OneVariable/ov-twin/README.md

# OneVariable Twin Trainer Hardware

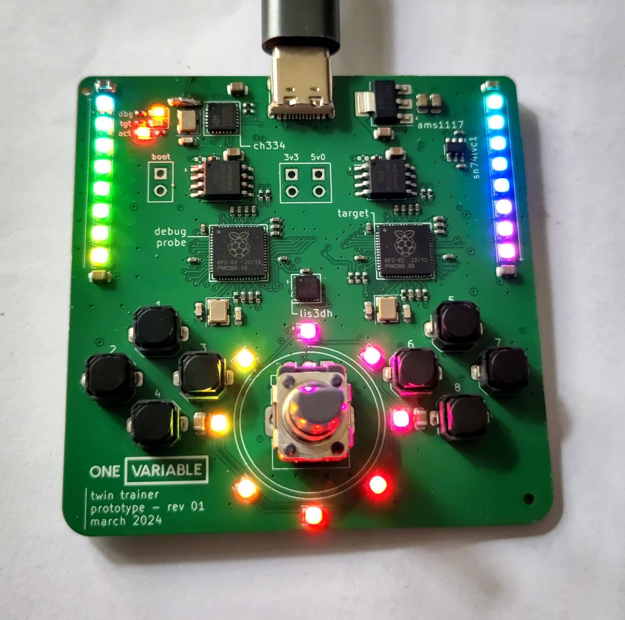
[picture p1: assets/ovtwin-001.jpg]
OV Twin Revision 1


Hardware for the OV Twin Trainer Board.

Designed for [RustNL 2024 Workshops](https://2024.rustnl.org/workshops/)

## Schematic

You can view the PDF schematic [here](./assets/ov-twin.pdf).
