OneVariable/ov-twin/ov-twin.kicad_pcb

## KiCad design ov-twin.kicad_pcb (2024-04-11)

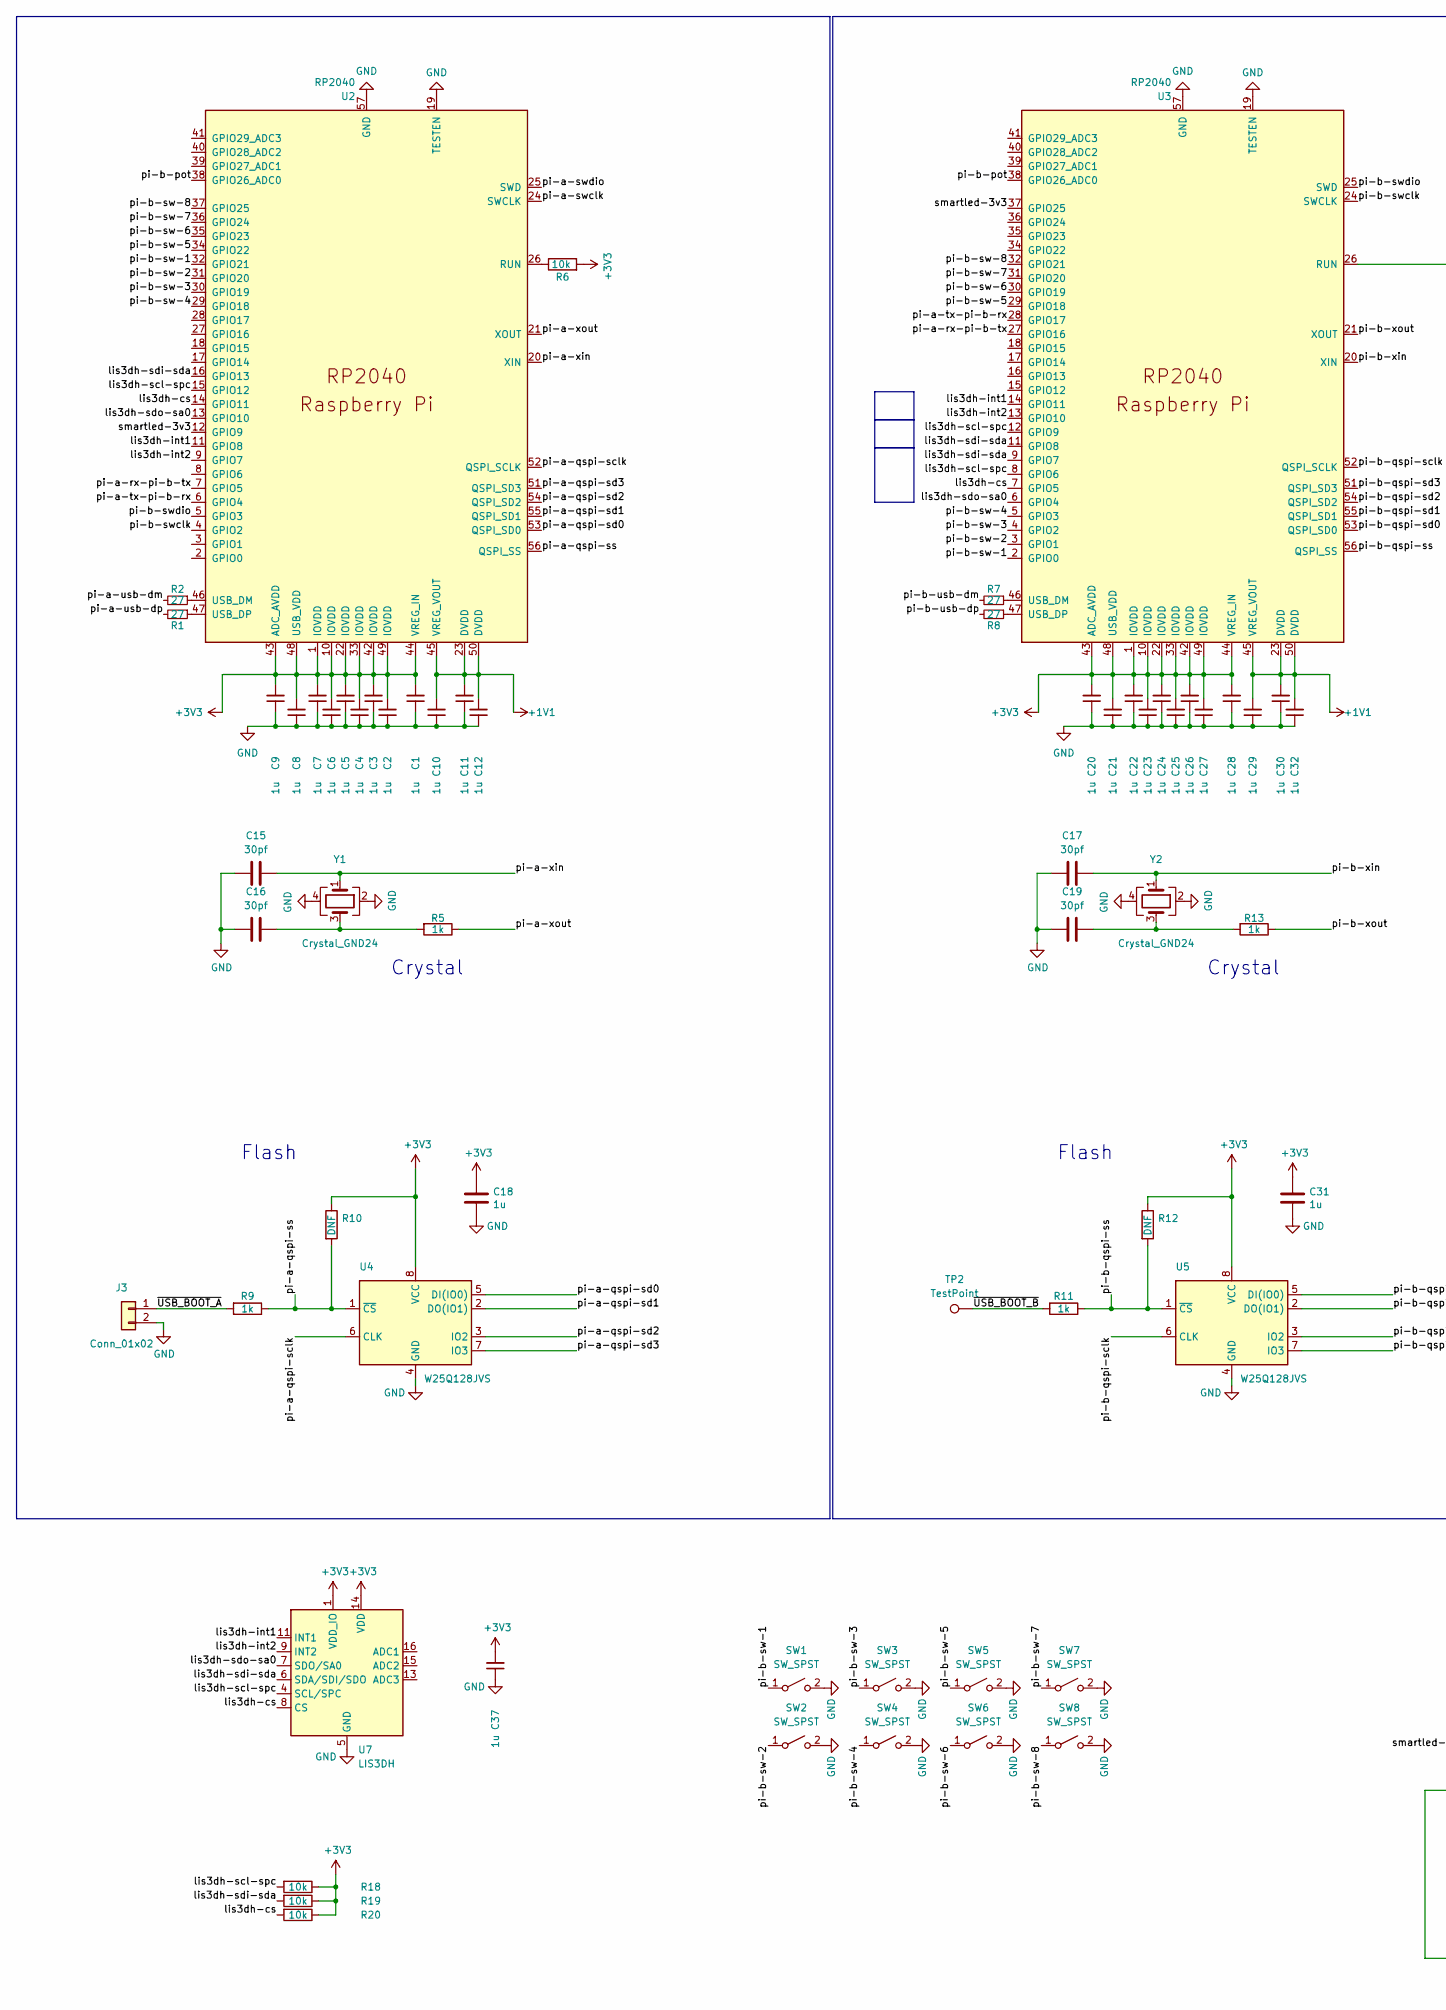
[picture p3: schematic ov-twin.kicad_sch, part in row 1, column 1]

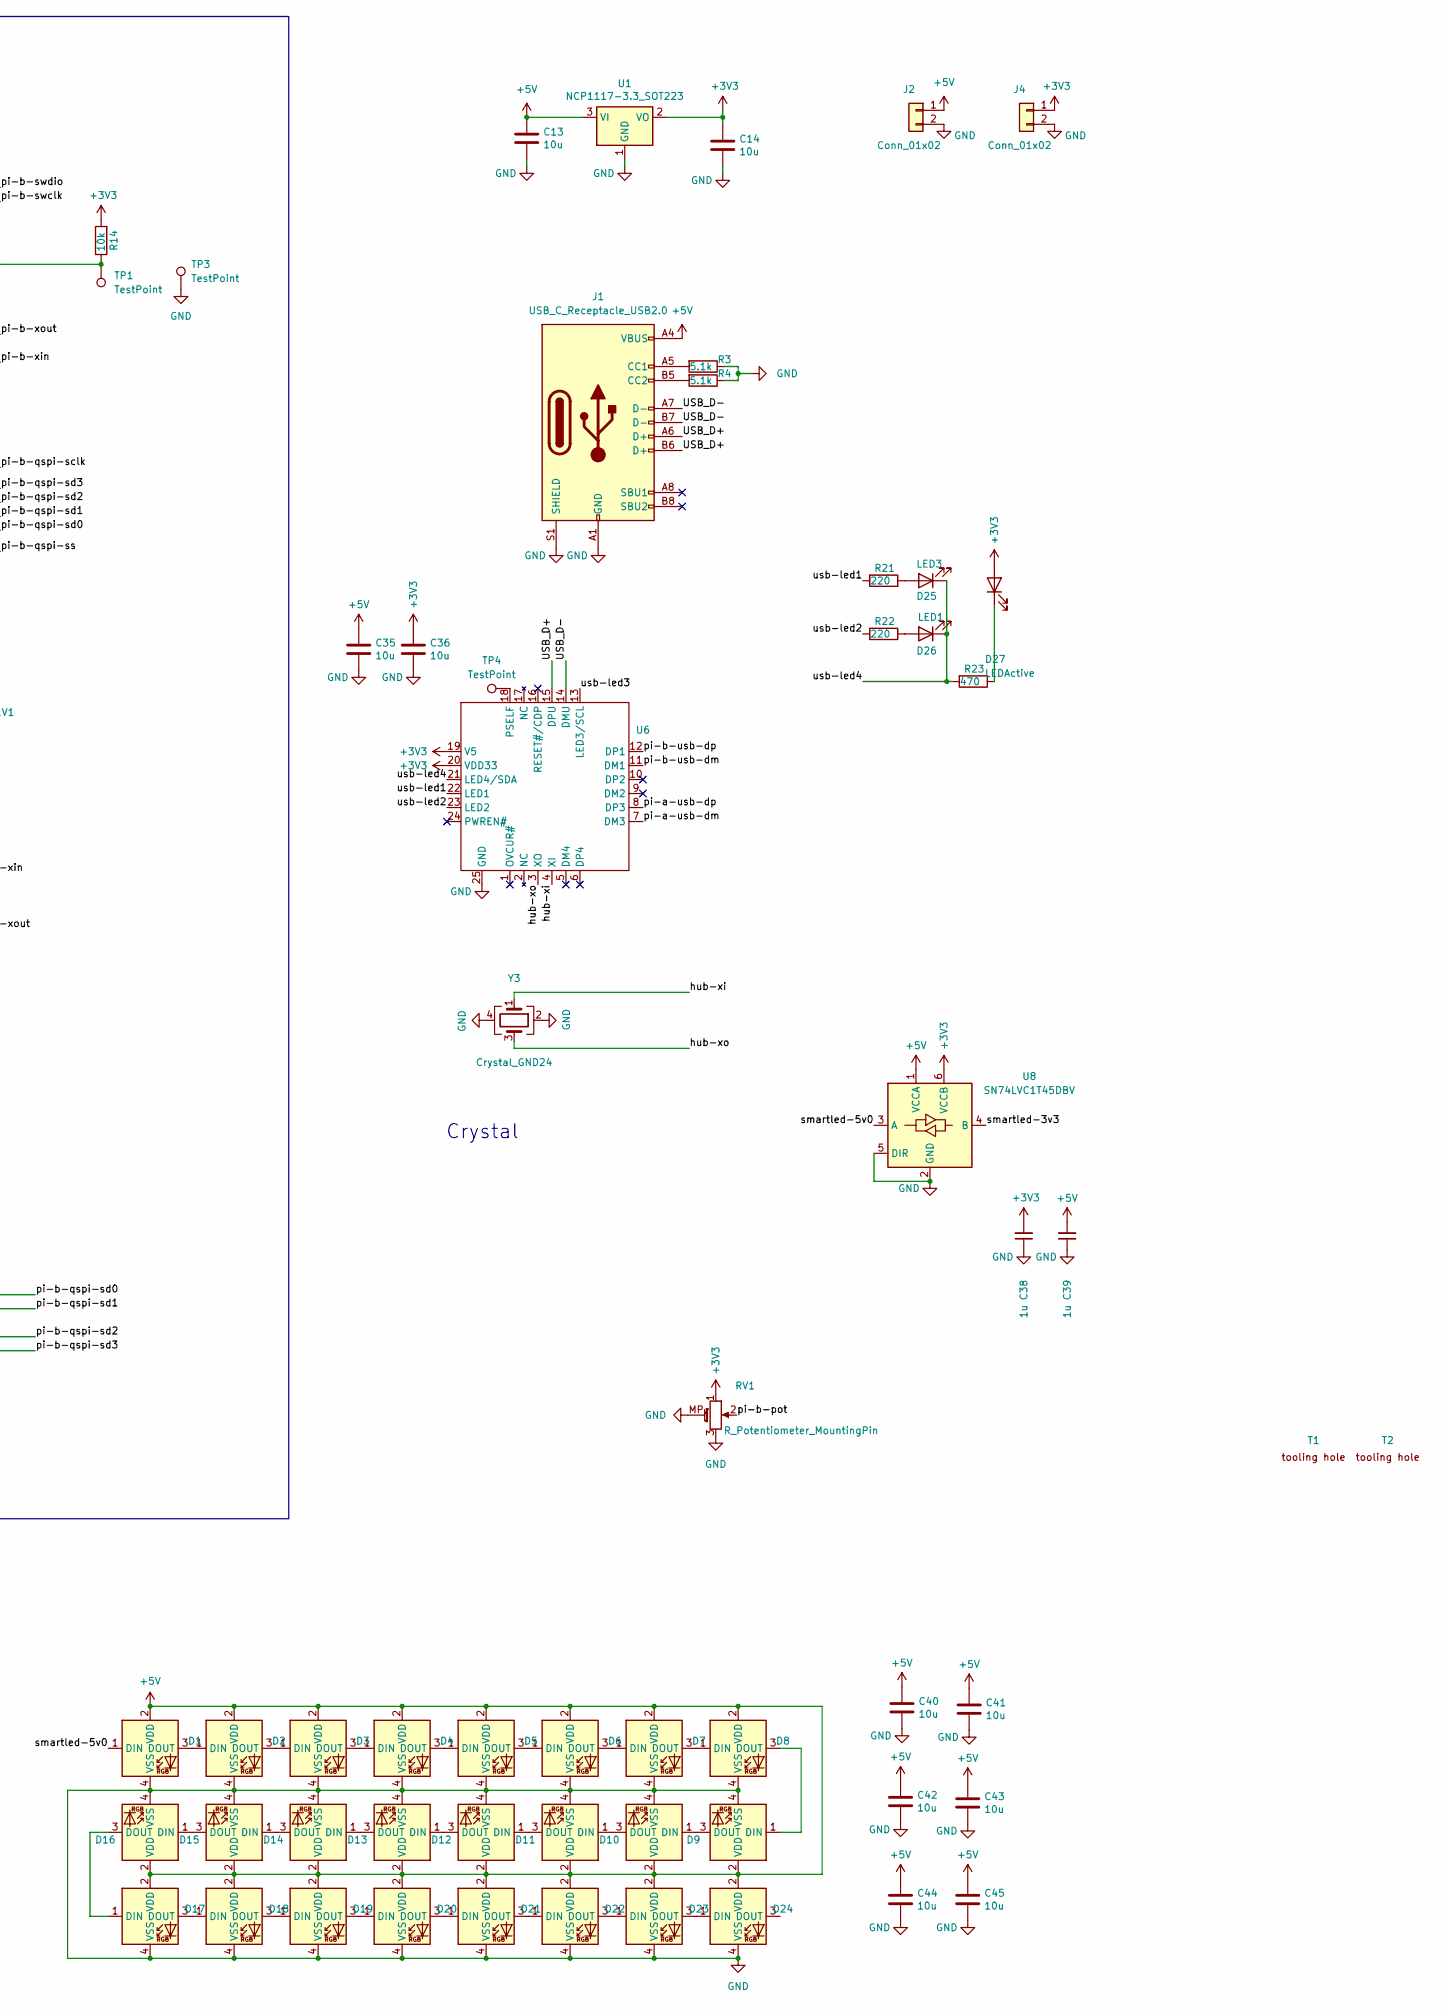
[picture p4: schematic ov-twin.kicad_sch, part in row 1, column 2]

Parts:
C1, C2, C3, C4, C5, C6, C7, C8, C9, C10, C11, C12, C20, C21, C22, C23, C24, C25, C26, C27, C28, C29, C30, C32, C37, C38, C39: 1u; C_0402_1005Metric
C13, C14, C35, C36, C40, C41, C42, C43, C44, C45: 10u; C_0805_2012Metric
C15, C16, C17, C19: 30pf; C_0603_1608Metric
C18, C31: 1u; C_0805_2012Metric
D1, D2, D3, D4, D5, D6, D7, D8, D9, D10, D11, D12, D13, D14, D15, D16, D17, D18, D19, D20, D21, D22, D23, D24: LED_WS2812B-2020_PLCC4_2.0x2.0mm
D25: LED3; LED_0603_1608Metric
D26: LED1; LED_0603_1608Metric
D27: LEDActive; LED_0603_1608Metric
J1: USB_C_Receptacle_USB2.0; USB_C_Receptacle_G-Switch_GT-USB-7010ASV
J2, J3, J4: Conn_01x02; PinHeader_1x02_P2.54mm_Vertical
R1, R2, R7, R8: 27; R_0402_1005Metric
R3, R4: 5.1k; R_0402_1005Metric
R5, R9, R11, R13: 1k; R_0402_1005Metric
R6, R14, R18, R19, R20: 10k; R_0402_1005Metric
R10, R12: DNF; R_0402_1005Metric
R21, R22: 220; R_0402_1005Metric
R23: 470; R_0402_1005Metric
RV1: R_Potentiometer_MountingPin; Potentiometer_Alps_RK09K_Single_Vertical
SW1, SW2, SW3, SW4, SW5, SW6, SW7, SW8: SW_SPST; k2-1817UQ
T1, T2: tooling-hole
TP1, TP2, TP3, TP4: TestPoint; TestPoint_Pad_D1.5mm
U1: NCP1117-3.3_SOT223; SOT-223-3_TabPin2
U2, U3: RP2040; RP2040-QFN-56
U4, U5: W25Q128JVS; SOIC-8_5.23x5.23mm_P1.27mm
U6: QFN-24-1EP_4x4mm_P0.5mm_EP2.7x2.7mm_ThermalVias
U7: LIS3DH; LGA-16_3x3mm_P0.5mm_LayoutBorder3x5y
U8: SN74LVC1T45DBV; SOT-23-6
Y1, Y2, Y3: Crystal_GND24; Crystal_SMD_3225-4Pin_3.2x2.5mm

Connections:
+1V1: C10.2, C11.2, C12.2, C29.2, C30.2, C32.2, U2.23 (DVDD), U2.45 (VREG_VOUT), U2.50 (DVDD), U3.23 (DVDD), U3.45 (VREG_VOUT), U3.50 (DVDD)
+3V3: C1.2, C2.2, C3.2, C4.2, C5.2, C6.2, C7.2, C8.2, C9.2, C14.1, C18.1, C20.2, C21.2, C22.2, C23.2, C24.2, C25.2, C26.2, C27.2, C28.2, C31.1, C36.1, C37.2, C38.2, D27.2 (A), J4.1, R6.2, R10.1, R12.1, R14.2, R18.1, R19.1, R20.1, RV1.1, U1.2 (VO), U2.1 (IOVDD), U2.10 (IOVDD), U2.22 (IOVDD), U2.33 (IOVDD), U2.42 (IOVDD), U2.43 (ADC_AVDD), U2.44 (VREG_IN), U2.48 (USB_VDD), U2.49 (IOVDD), U3.1 (IOVDD), U3.10 (IOVDD), U3.22 (IOVDD), U3.33 (IOVDD), U3.42 (IOVDD), U3.43 (ADC_AVDD), U3.44 (VREG_IN), U3.48 (USB_VDD), U3.49 (IOVDD), U4.8 (VCC), U5.8 (VCC), U6.19 (V5), U6.20 (VDD33), U7.1 (VDD_IO), U7.14 (VDD), U8.6 (VCCB)
+5V: C13.1, C35.1, C39.2, C40.1, C41.1, C42.1, C43.1, C44.1, C45.1, D1.2 (VDD), D2.2 (VDD), D3.2 (VDD), D4.2 (VDD), D5.2 (VDD), D6.2 (VDD), D7.2 (VDD), D8.2 (VDD), D9.2 (VDD), D10.2 (VDD), D11.2 (VDD), D12.2 (VDD), D13.2 (VDD), D14.2 (VDD), D15.2 (VDD), D16.2 (VDD), D17.2 (VDD), D18.2 (VDD), D19.2 (VDD), D20.2 (VDD), D21.2 (VDD), D22.2 (VDD), D23.2 (VDD), D24.2 (VDD), J1.A4 (VBUS), J1.A9 (VBUS), J1.B4 (VBUS), J1.B9 (VBUS), J2.1, U1.3 (VI), U8.1 (VCCA)
/USB_D+: J1.A6 (D+), J1.B6 (D+), U6.15 (DPU)
/USB_D-: J1.A7 (D-), J1.B7 (D-), U6.14 (DMU)
/hub-xi: U6.4 (XI), Y3.1
/hub-xo: U6.3 (XO), Y3.3
/lis3dh-cs: R20.2, U2.14 (GPIO11), U3.7 (GPIO5), U7.8 (CS)
/lis3dh-int1: U2.11 (GPIO8), U3.14 (GPIO11), U7.11 (INT1)
/lis3dh-int2: U2.9 (GPIO7), U3.13 (GPIO10), U7.9 (INT2)
/lis3dh-scl-spc: R18.2, U2.15 (GPIO12), U3.8 (GPIO6), U3.12 (GPIO9), U7.4 (SCL/SPC)
/lis3dh-sdi-sda: R19.2, U2.16 (GPIO13), U3.9 (GPIO7), U3.11 (GPIO8), U7.6 (SDA/SDI/SDO)
/lis3dh-sdo-sa0: U2.13 (GPIO10), U3.6 (GPIO4), U7.7 (SDO/SA0)
/pi-a-qspi-sclk: U2.52 (QSPI_SCLK), U4.6 (CLK)
/pi-a-qspi-sd0: U2.53 (QSPI_SD0), U4.5 (DI(IO0))
/pi-a-qspi-sd1: U2.55 (QSPI_SD1), U4.2 (DO(IO1))
/pi-a-qspi-sd2: U2.54 (QSPI_SD2), U4.3 (IO2)
/pi-a-qspi-sd3: U2.51 (QSPI_SD3), U4.7 (IO3)
/pi-a-qspi-ss: R9.1, R10.2, U2.56 (QSPI_SS), U4.1 (~CS)
/pi-a-rx-pi-b-tx: U2.7 (GPIO5), U3.27 (GPIO16)
/pi-a-swclk: U2.24 (SWCLK)
/pi-a-swdio: U2.25 (SWD)
/pi-a-tx-pi-b-rx: U2.6 (GPIO4), U3.28 (GPIO17)
/pi-a-usb-dm: R2.2, U6.7 (DM3)
/pi-a-usb-dp: R1.2, U6.8 (DP3)
/pi-a-xin: C15.2, U2.20 (XIN), Y1.1
/pi-a-xout: R5.1, U2.21 (XOUT)
/pi-b-pot: RV1.2, U2.38 (GPIO26_ADC0), U3.38 (GPIO26_ADC0)
/pi-b-qspi-sclk: U3.52 (QSPI_SCLK), U5.6 (CLK)
/pi-b-qspi-sd0: U3.53 (QSPI_SD0), U5.5 (DI(IO0))
/pi-b-qspi-sd1: U3.55 (QSPI_SD1), U5.2 (DO(IO1))
/pi-b-qspi-sd2: U3.54 (QSPI_SD2), U5.3 (IO2)
/pi-b-qspi-sd3: U3.51 (QSPI_SD3), U5.7 (IO3)
/pi-b-qspi-ss: R11.1, R12.2, U3.56 (QSPI_SS), U5.1 (~CS)
/pi-b-sw-1: SW1.1 (A), U2.32 (GPIO21), U3.2 (GPIO0)
/pi-b-sw-2: SW2.1 (A), U2.31 (GPIO20), U3.3 (GPIO1)
/pi-b-sw-3: SW3.1 (A), U2.30 (GPIO19), U3.4 (GPIO2)
/pi-b-sw-4: SW4.1 (A), U2.29 (GPIO18), U3.5 (GPIO3)
/pi-b-sw-5: SW5.1 (A), U2.34 (GPIO22), U3.29 (GPIO18)
/pi-b-sw-6: SW6.1 (A), U2.35 (GPIO23), U3.30 (GPIO19)
/pi-b-sw-7: SW7.1 (A), U2.36 (GPIO24), U3.31 (GPIO20)
/pi-b-sw-8: SW8.1 (A), U2.37 (GPIO25), U3.32 (GPIO21)
/pi-b-swclk: U2.4 (GPIO2), U3.24 (SWCLK)
/pi-b-swdio: U2.5 (GPIO3), U3.25 (SWD)
/pi-b-usb-dm: R7.2, U6.11 (DM1)
/pi-b-usb-dp: R8.2, U6.12 (DP1)
/pi-b-xin: C17.2, U3.20 (XIN), Y2.1
/pi-b-xout: R13.1, U3.21 (XOUT)
/smartled-3v3: U2.12 (GPIO9), U3.37 (GPIO25), U8.4 (B)
/smartled-5v0: D1.1 (DIN), U8.3 (A)
/usb-led1: R21.2, U6.22 (LED1)
/usb-led2: R22.2, U6.23 (LED2)
/usb-led3: U6.13 (LED3/SCL)
/usb-led4: D25.1 (K), D26.1 (K), R23.2, U6.21 (LED4/SDA)
/~USB_BOOT_A: J3.1, R9.2
/~USB_BOOT_B: R11.2, TP2.1
GND: C1.1, C2.1, C3.1, C4.1, C5.1, C6.1, C7.1, C8.1, C9.1, C10.1, C11.1, C12.1, C13.2, C14.2, C15.1, C16.1, C17.1, C18.2, C19.1, C20.1, C21.1, C22.1, C23.1, C24.1, C25.1, C26.1, C27.1, C28.1, C29.1, C30.1, C31.2, C32.1, C35.2, C36.2, C37.1, C38.1, C39.1, C40.2, C41.2, C42.2, C43.2, C44.2, C45.2, D1.4 (VSS), D2.4 (VSS), D3.4 (VSS), D4.4 (VSS), D5.4 (VSS), D6.4 (VSS), D7.4 (VSS), D8.4 (VSS), D9.4 (VSS), D10.4 (VSS), D11.4 (VSS), D12.4 (VSS), D13.4 (VSS), D14.4 (VSS), D15.4 (VSS), D16.4 (VSS), D17.4 (VSS), D18.4 (VSS), D19.4 (VSS), D20.4 (VSS), D21.4 (VSS), D22.4 (VSS), D23.4 (VSS), D24.4 (VSS), J1.A1 (GND), J1.A12 (GND), J1.B1 (GND), J1.B12 (GND), J1.S1 (SHIELD), J2.2, J3.2, J4.2, R3.1, R4.1, RV1.3, RV1.MP (MountPin), SW1.2 (B), SW2.2 (B), SW3.2 (B), SW4.2 (B), SW5.2 (B), SW6.2 (B), SW7.2 (B), SW8.2 (B), TP3.1, U1.1 (GND), U2.19 (TESTEN), U2.57 (GND), U3.19 (TESTEN), U3.57 (GND), U4.4 (GND), U5.4 (GND), U6.25 (GND), U7.5 (GND), U7.10 (GND), U7.12 (GND), U8.2 (GND), U8.5 (DIR), Y1.2, Y1.4, Y2.2, Y2.4, Y3.2, Y3.4
unnamed: C16.2, R5.2, Y1.3
unnamed: C19.2, R13.2, Y2.3
unnamed: D1.3 (DOUT), D2.1 (DIN)
unnamed: D2.3 (DOUT), D3.1 (DIN)
unnamed: D3.3 (DOUT), D4.1 (DIN)
unnamed: D4.3 (DOUT), D5.1 (DIN)
unnamed: D5.3 (DOUT), D6.1 (DIN)
unnamed: D6.3 (DOUT), D7.1 (DIN)
unnamed: D7.3 (DOUT), D8.1 (DIN)
unnamed: D8.3 (DOUT), D9.1 (DIN)
unnamed: D9.3 (DOUT), D10.1 (DIN)
unnamed: D10.3 (DOUT), D11.1 (DIN)
unnamed: D11.3 (DOUT), D12.1 (DIN)
unnamed: D12.3 (DOUT), D13.1 (DIN)
unnamed: D13.3 (DOUT), D14.1 (DIN)
unnamed: D14.3 (DOUT), D15.1 (DIN)
unnamed: D15.3 (DOUT), D16.1 (DIN)
unnamed: D16.3 (DOUT), D17.1 (DIN)
unnamed: D17.3 (DOUT), D18.1 (DIN)
unnamed: D18.3 (DOUT), D19.1 (DIN)
unnamed: D19.3 (DOUT), D20.1 (DIN)
unnamed: D20.3 (DOUT), D21.1 (DIN)
unnamed: D21.3 (DOUT), D22.1 (DIN)
unnamed: D22.3 (DOUT), D23.1 (DIN)
unnamed: D23.3 (DOUT), D24.1 (DIN)
unnamed: D25.2 (A), R21.1
unnamed: D26.2 (A), R22.1
unnamed: D27.1 (K), R23.1
unnamed: J1.A5 (CC1), R3.2
unnamed: J1.B5 (CC2), R4.2
unnamed: R6.1, U2.26 (RUN)
unnamed: R2.1, U2.46 (USB_DM)
unnamed: R1.1, U2.47 (USB_DP)
unnamed: R14.1, TP1.1, U3.26 (RUN)
unnamed: R7.1, U3.46 (USB_DM)
unnamed: R8.1, U3.47 (USB_DP)
unnamed: TP4.1, U6.18 (PSELF)

Notes on the sheet:
Crystal
Flash

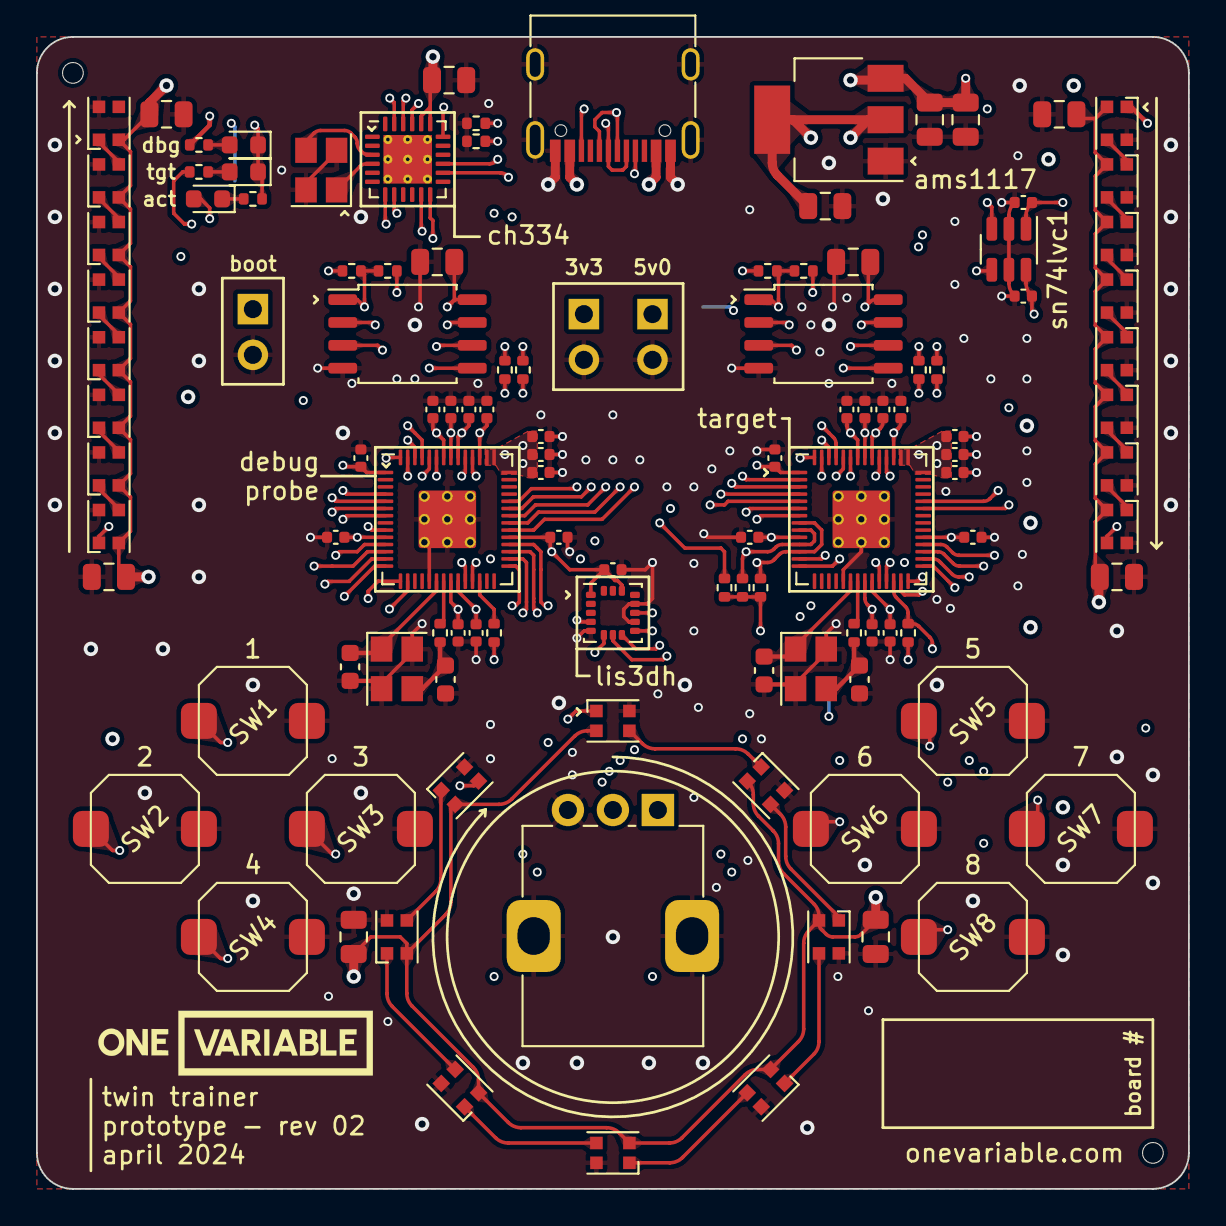
[picture p5: board ov-twin.kicad_pcb from above]

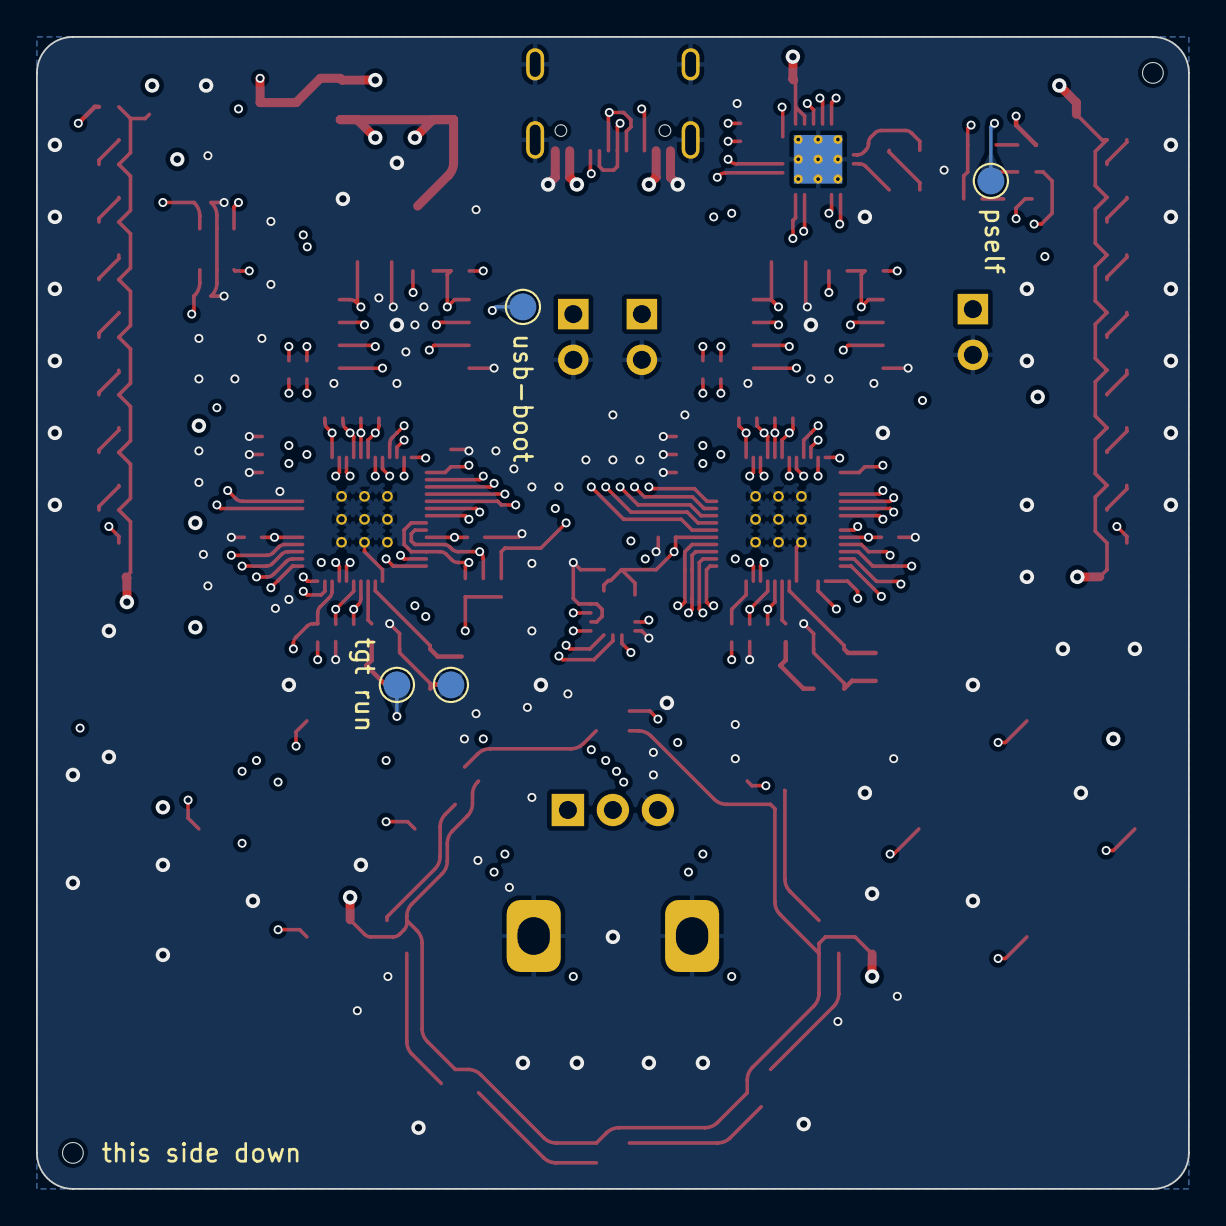
[picture p6: board ov-twin.kicad_pcb from below]

Board: 4 copper layers, 64.0 x 64.0 mm, 120 parts (4 on the bottom side), 91 nets.
