OneVariable/ov-twin/(commit log)

2024-03-13 One rp2040 placed and mostly routed
    [ov-twin.kicad_pcb, ov-twin.kicad_sch]
2024-03-14 Hub and stuff
    [ov-twin.kicad_pcb, ov-twin.kicad_sch]
2024-03-15 Mostly routed, wondering how to do sniffing
    [ov-twin.kicad_pcb, ov-twin.kicad_sch]
2024-03-15 Okay let's try it
    [ov-twin.kicad_pcb]
2024-03-15 Add missing decoupling and such
    [ov-twin.kicad_pcb, ov-twin.kicad_sch]
2024-03-15 That worked pretty well I thought!
    [ov-twin.kicad_pcb, ov-twin.kicad_sch]
2024-04-11 Second order
    [ov-twin.kicad_pcb, ov-twin.kicad_sch]
2024-05-03 Plot schematic (and clean up schematic a bit)
    [ov-twin.kicad_sch]
2024-05-03 Add link to schematic
